mayermakes/Duet-2-Hardware/Duet_Expansion/Expansion_big_Drivers/ExpBIGGERBreakout.png

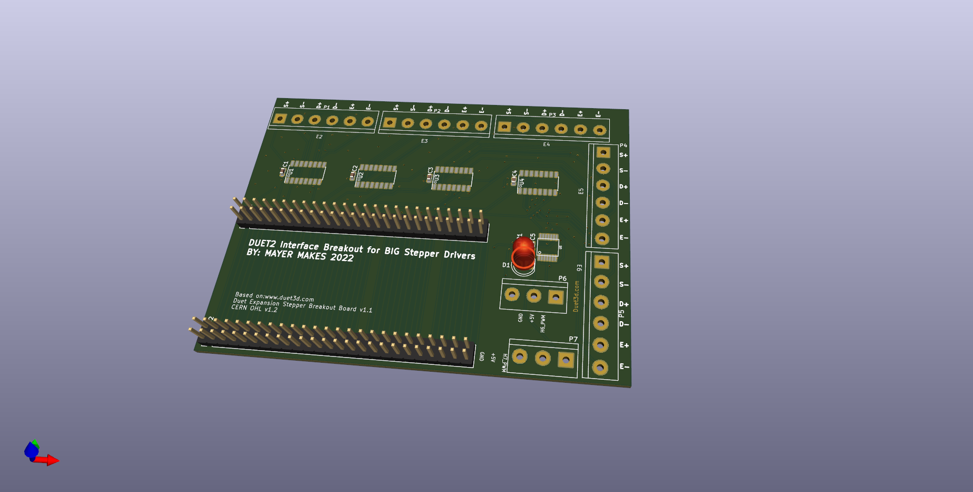
Duet_Expansion/Expansion_big_Drivers/ExpBIGGERBreakout.png
