mayermakes/Duet-2-Hardware/Duet_Expansion/Expansion_big_Drivers/Readme.txt

Variation on the Expansion Board 1.1 to connect big Stepper drivers (like DM556 etc.)
Easier to Access pins if used with DUEX5
Bigger pads to Solder to / for 5.08mm pitch Screw Terminals
Schematic is mostly unchanged for compability.
Power indicator LED added.

This board was designed for a CNC Blog series by @MAYERMAKES on Element14.com
https://community.element14.com/technologies/motors-and-drives/b/clem-s-cnc-control-project

At the time of writing the Expansion Breakout was unavailable, thanks to the OSHW nature of Duet boards
this was a quick solution to make a Duet2 ethernet work with DM556 Stepper drivers.
Thanks for you commitment to Open source hardware.
