mayermakes/Duet-2-Hardware/Duet_Expansion/Expansion_big_Drivers/ExpBreakout.kicad_pcb

## KiCad design Duet_Expansion/Expansion_big_Drivers/ExpBreakout.kicad_pcb (2022-11-03)

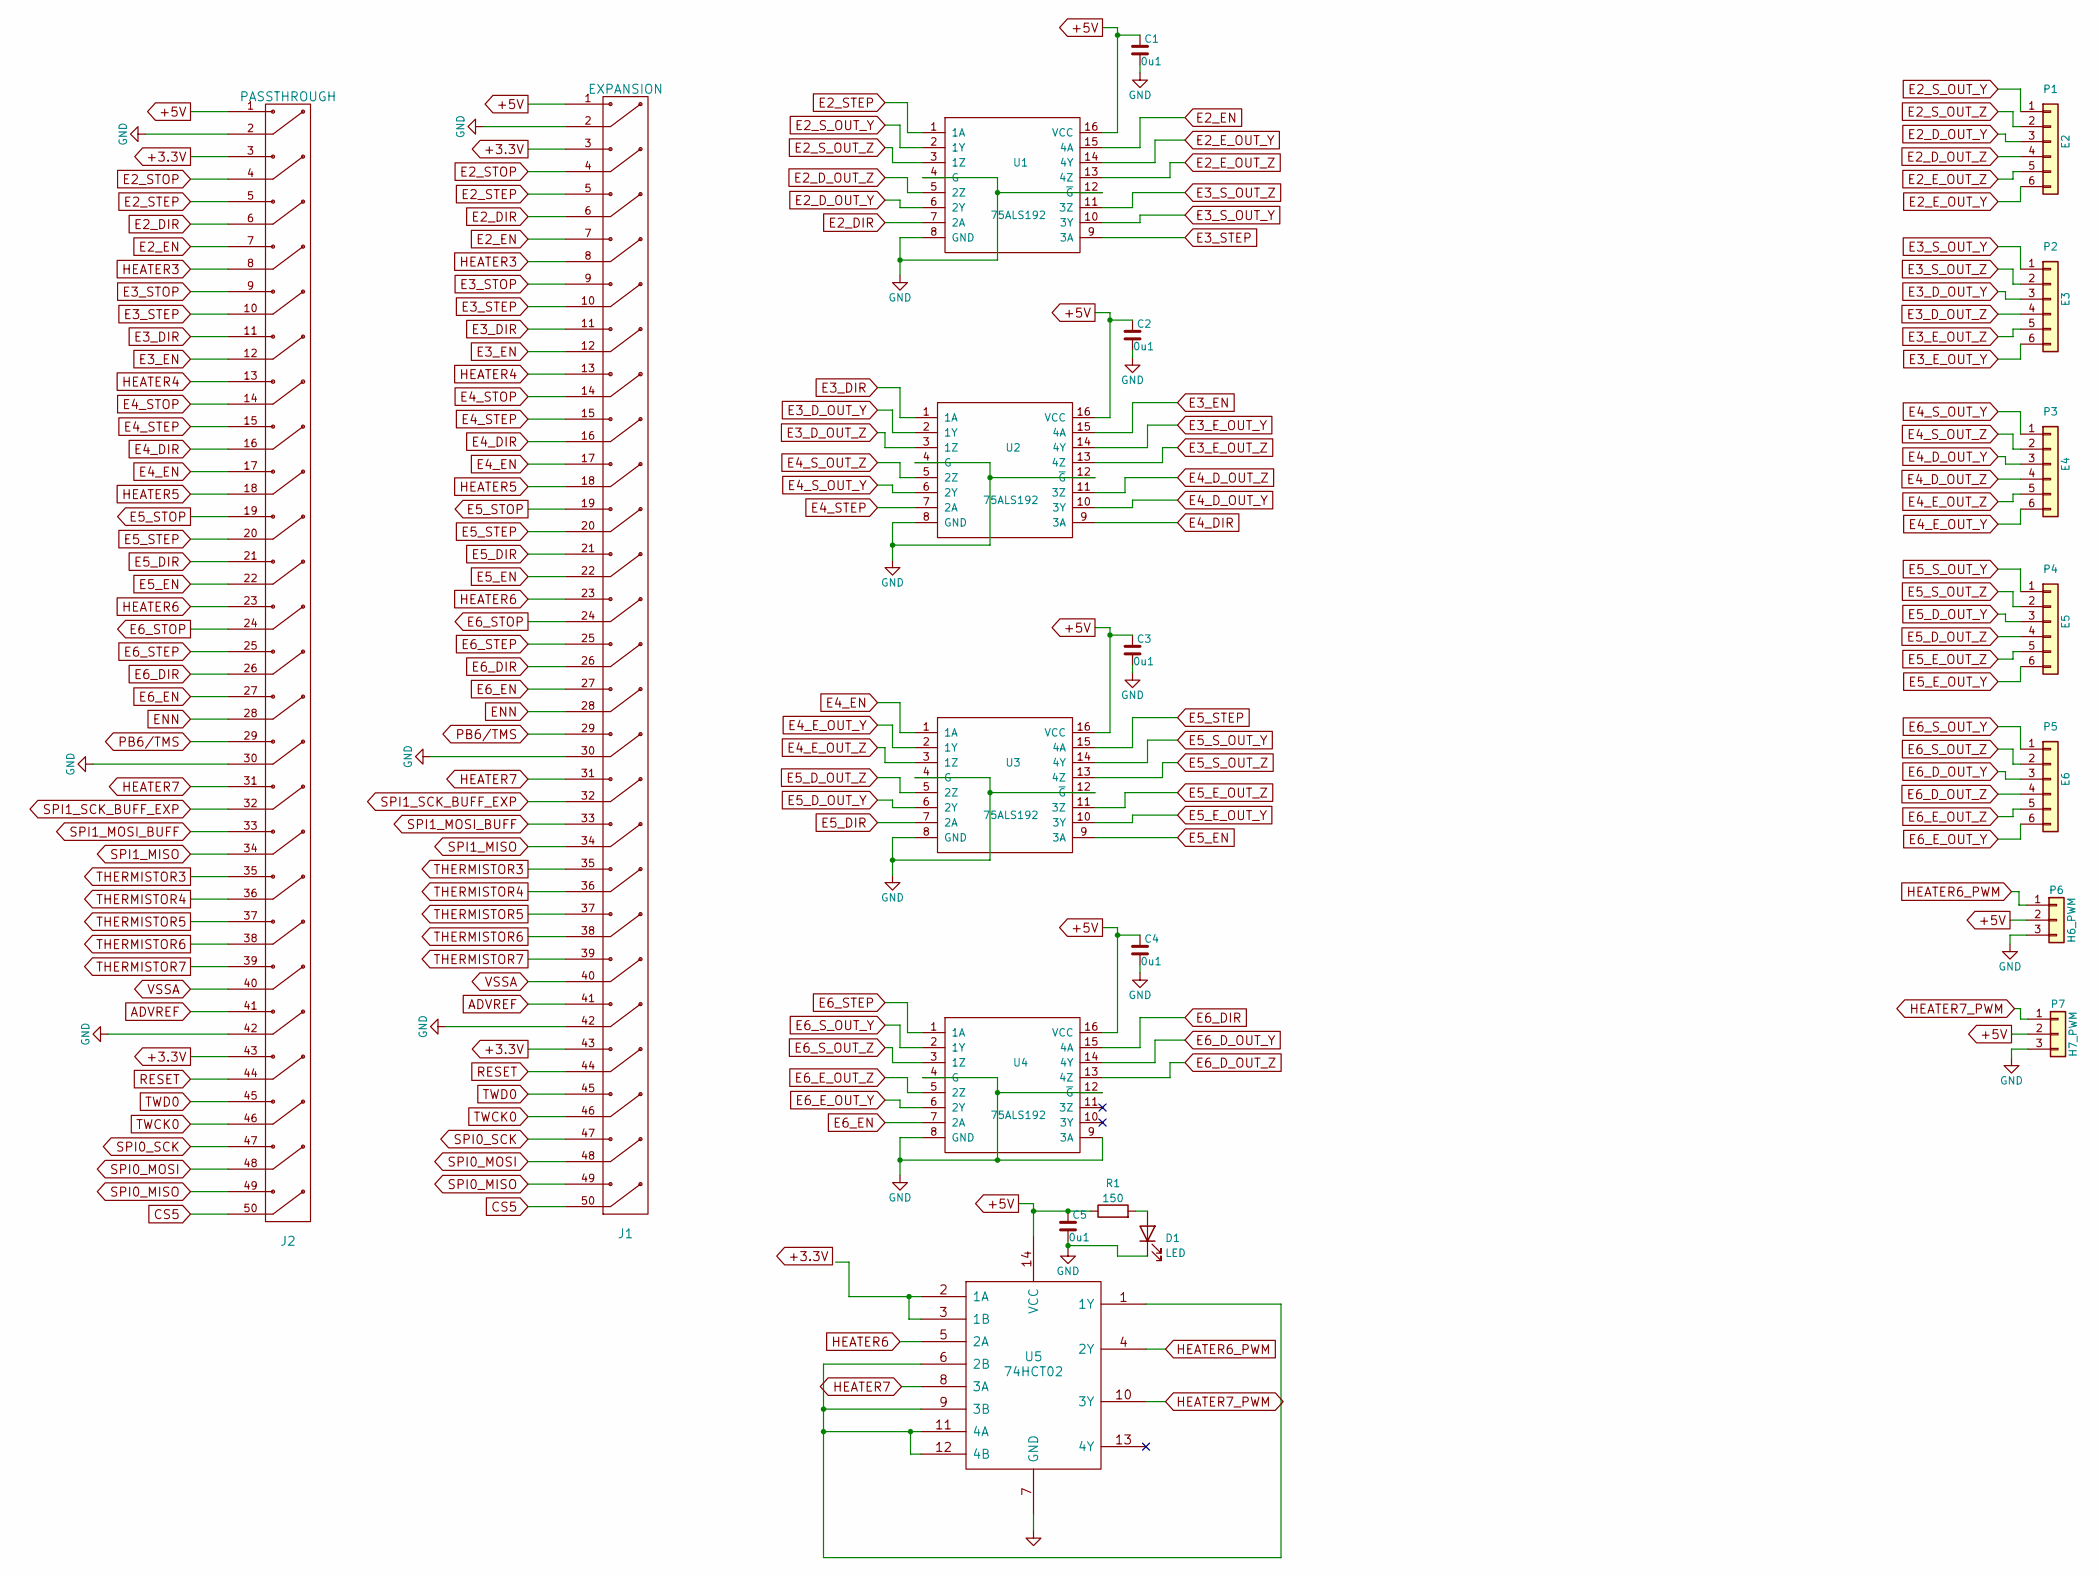
[picture p2: schematic ExpBreakout.kicad_sch, Expansion Breakout]

Parts:
C1, C2, C3, C4, C5: 0u1; C_0603_1608Metric
D1: LED; LED_D5.0mm
J1: EXPANSION; PinHeader_2x25_P2.54mm_Vertical
J2: PASSTHROUGH; PinHeader_2x25_P2.54mm_Vertical
P1: E2; TerminalBlock_bornier-6_P5.08mm
P2: E3; TerminalBlock_bornier-6_P5.08mm
P3: E4; TerminalBlock_bornier-6_P5.08mm
P4: E5; TerminalBlock_bornier-6_P5.08mm
P5: E6; TerminalBlock_bornier-6_P5.08mm
P6: H6_PWM; TerminalBlock_bornier-3_P5.08mm
P7: H7_PWM; TerminalBlock_bornier-3_P5.08mm
R1: 150; R_0603_1608Metric
U1, U2, U3, U4: 75ALS192; SOIC-16_3.9x9.9mm_Pitch1.27mm
U5: 74HCT02; TSSOP-14

Connections:
+3.3V: J1.3, J1.43, J2.3, J2.43
+5V: C1.1, C2.1, C3.1, C4.1, C5.1, J1.1, J2.1, P6.2, P7.2, R1.1, U1.16 (VCC), U2.16 (VCC), U3.16 (VCC), U4.16 (VCC), U5.14 (VCC)
ADVREF: J1.41, J2.41
CS5: J1.50, J2.50
E2_DIR: J1.6, J2.6, U1.7 (2A)
E2_D_OUT_Y: P1.3, U1.6 (2Y)
E2_D_OUT_Z: P1.4, U1.5 (2Z)
E2_EN: J1.7, J2.7, U1.15 (4A)
E2_E_OUT_Y: P1.6, U1.14 (4Y)
E2_E_OUT_Z: P1.5, U1.13 (4Z)
E2_STEP: J1.5, J2.5, U1.1 (1A)
E2_STOP: J1.4, J2.4
E2_S_OUT_Y: P1.1, U1.2 (1Y)
E2_S_OUT_Z: P1.2, U1.3 (1Z)
E3_DIR: J1.11, J2.11, U2.1 (1A)
E3_D_OUT_Y: P2.3, U2.2 (1Y)
E3_D_OUT_Z: P2.4, U2.3 (1Z)
E3_EN: J1.12, J2.12, U2.15 (4A)
E3_E_OUT_Y: P2.6, U2.14 (4Y)
E3_E_OUT_Z: P2.5, U2.13 (4Z)
E3_STEP: J1.10, J2.10, U1.9 (3A)
E3_STOP: J1.9, J2.9
E3_S_OUT_Y: P2.1, U1.10 (3Y)
E3_S_OUT_Z: P2.2, U1.11 (3Z)
E4_DIR: J1.16, J2.16, U2.9 (3A)
E4_D_OUT_Y: P3.3, U2.10 (3Y)
E4_D_OUT_Z: P3.4, U2.11 (3Z)
E4_EN: J1.17, J2.17, U3.1 (1A)
E4_E_OUT_Y: P3.6, U3.2 (1Y)
E4_E_OUT_Z: P3.5, U3.3 (1Z)
E4_STEP: J1.15, J2.15, U2.7 (2A)
E4_STOP: J1.14, J2.14
E4_S_OUT_Y: P3.1, U2.6 (2Y)
E4_S_OUT_Z: P3.2, U2.5 (2Z)
E5_DIR: J1.21, J2.21, U3.7 (2A)
E5_D_OUT_Y: P4.3, U3.6 (2Y)
E5_D_OUT_Z: P4.4, U3.5 (2Z)
E5_EN: J1.22, J2.22, U3.9 (3A)
E5_E_OUT_Y: P4.6, U3.10 (3Y)
E5_E_OUT_Z: P4.5, U3.11 (3Z)
E5_STEP: J1.20, J2.20, U3.15 (4A)
E5_STOP: J1.19, J2.19
E5_S_OUT_Y: P4.1, U3.14 (4Y)
E5_S_OUT_Z: P4.2, U3.13 (4Z)
E6_DIR: J1.26, J2.26, U4.15 (4A)
E6_D_OUT_Y: P5.3, U4.14 (4Y)
E6_D_OUT_Z: P5.4, U4.13 (4Z)
E6_EN: J1.27, J2.27, U4.7 (2A)
E6_E_OUT_Y: P5.6, U4.6 (2Y)
E6_E_OUT_Z: P5.5, U4.5 (2Z)
E6_STEP: J1.25, J2.25, U4.1 (1A)
E6_STOP: J1.24, J2.24
E6_S_OUT_Y: P5.1, U4.2 (1Y)
E6_S_OUT_Z: P5.2, U4.3 (1Z)
ENN: J1.28, J2.28
GND: C1.2, C2.2, C3.2, C4.2, C5.2, D1.1 (K), J1.2, J1.30, J1.42, J2.2, J2.30, J2.42, P6.3, P7.3, U1.4 (G), U1.8 (GND), U1.12 (~G), U2.4 (G), U2.8 (GND), U2.12 (~G), U3.4 (G), U3.8 (GND), U3.12 (~G), U4.4 (G), U4.8 (GND), U4.9 (3A), U4.12 (~G), U5.7 (GND)
HEATER3: J1.8, J2.8
HEATER4: J1.13, J2.13
HEATER5: J1.18, J2.18
HEATER6: J1.23, J2.23, U5.5 (2A)
HEATER6_PWM: P6.1, U5.4 (2Y)
HEATER7: J1.31, J2.31, U5.8 (3A)
HEATER7_PWM: P7.1, U5.10 (3Y)
unnamed: D1.2 (A), R1.2
unnamed: U5.1 (1Y), U5.6 (2B), U5.9 (3B), U5.11 (4A), U5.12 (4B)
unnamed: U5.2 (1A), U5.3 (1B)
PB6/TMS: J1.29, J2.29
RESET: J1.44, J2.44
SPI0_MISO: J1.49, J2.49
SPI0_MOSI: J1.48, J2.48
SPI0_SCK: J1.47, J2.47
SPI1_MISO: J1.34, J2.34
SPI1_MOSI_BUFF: J1.33, J2.33
SPI1_SCK_BUFF_EXP: J1.32, J2.32
THERMISTOR3: J1.35, J2.35
THERMISTOR4: J1.36, J2.36
THERMISTOR5: J1.37, J2.37
THERMISTOR6: J1.38, J2.38
THERMISTOR7: J1.39, J2.39
TWCK0: J1.46, J2.46
TWD0: J1.45, J2.45
VSSA: J1.40, J2.40

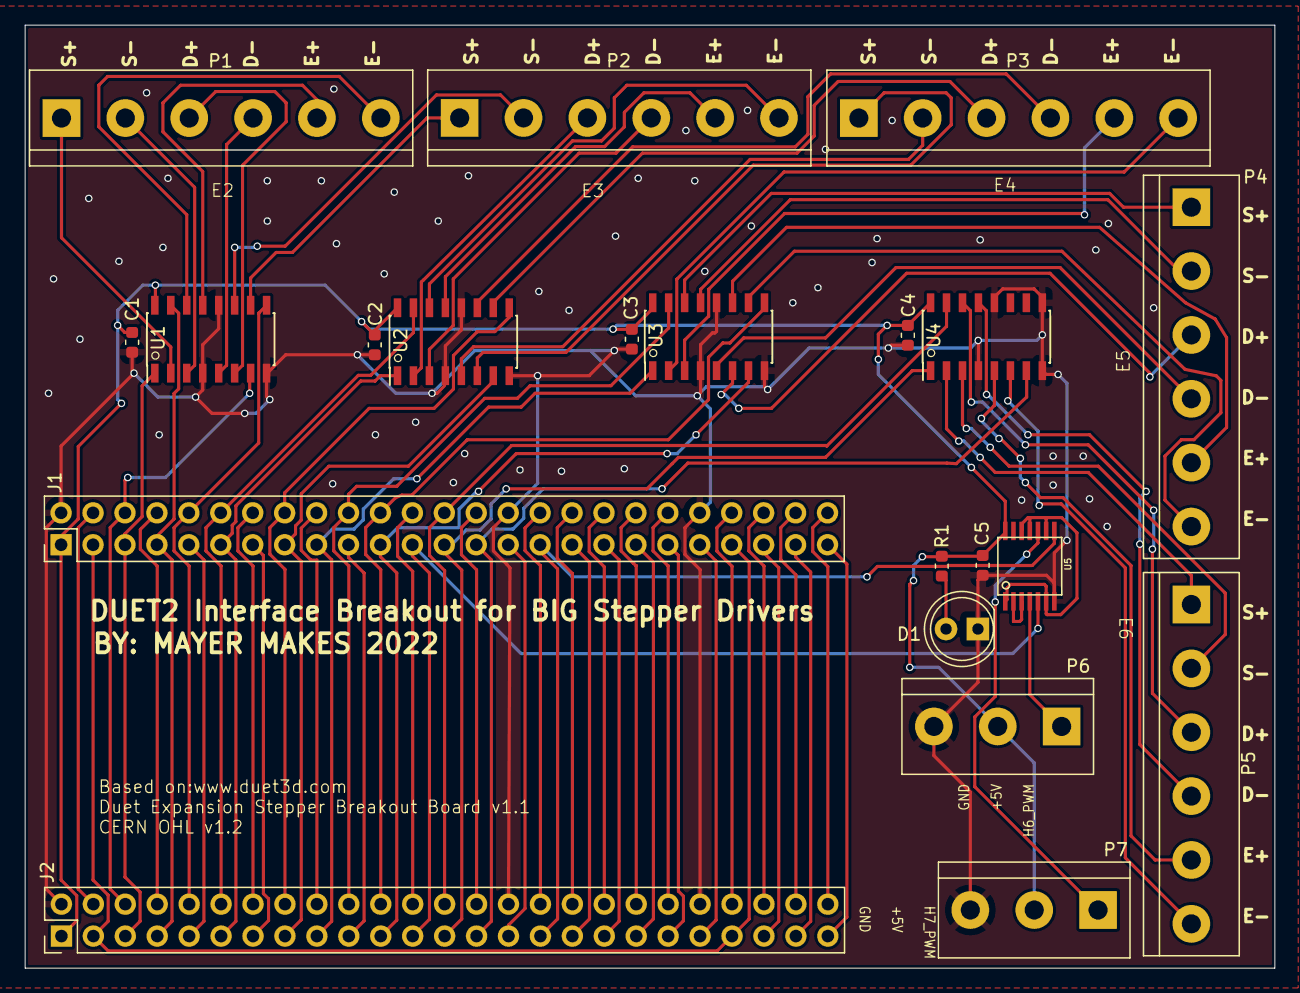
[picture p3: board ExpBreakout.kicad_pcb from above]

Board: 2 copper layers, 99.4 x 75.0 mm, 21 parts (0 on the bottom side), 82 nets.
