mayermakes/Duet-2-Hardware/(notices)

Notices in the files:
Duet_Expansion/Expansion_big_Drivers/ExpBreakout.kicad_pcb:
CERN OHL v1.2
